r-gal/CNC/PCB/axePort_sch.kicad_sch

## KiCad design PCB/axePort_sch.kicad_sch (2025-07-07)

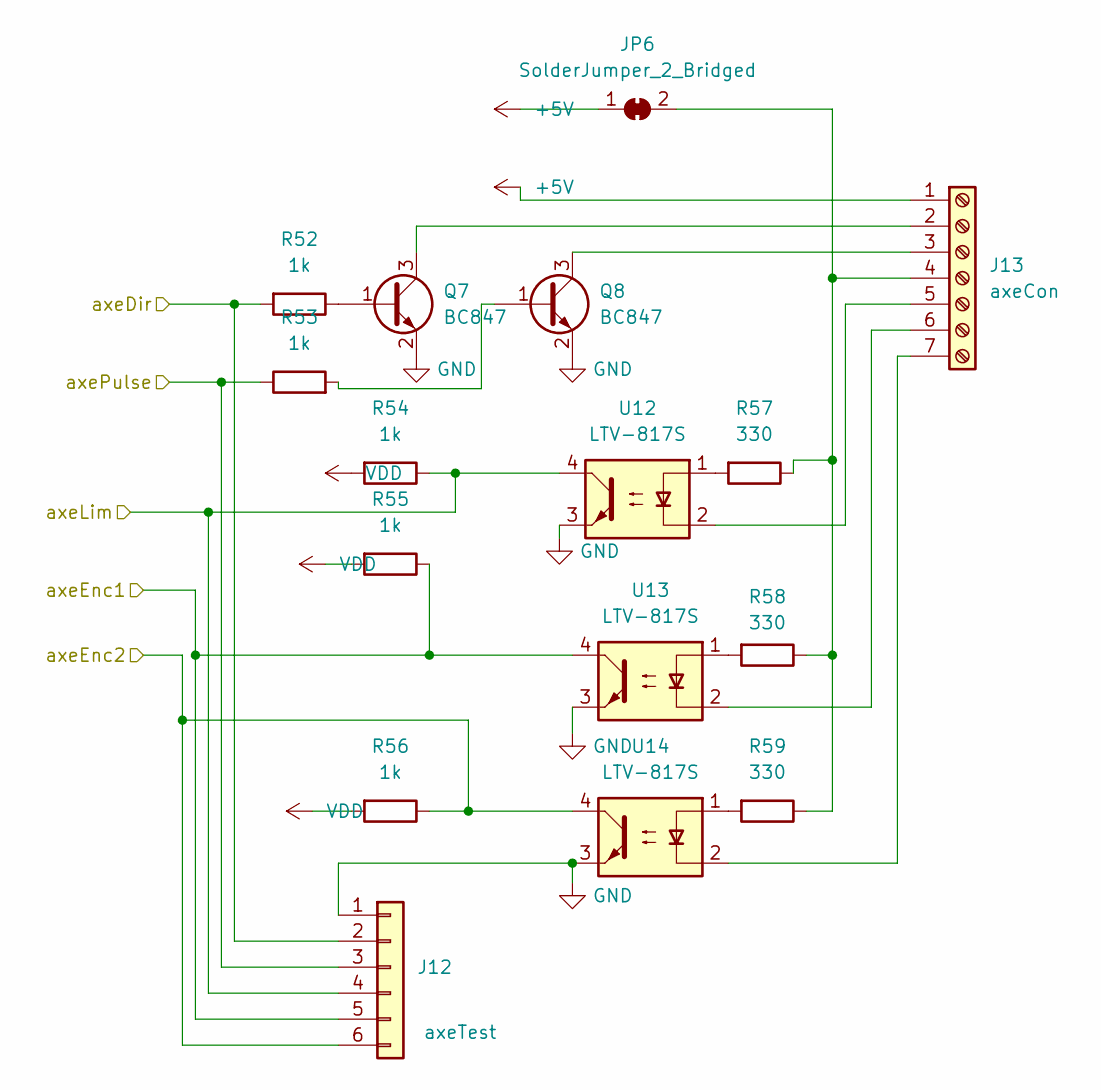
[picture p1: schematic axePort_sch.kicad_sch]

Parts:
J12: axeTest; PinHeader_1x06_P2.54mm_Vertical
J13: axeCon; TerminalBlock_4Ucon_1x07_P3.50mm_Horizontal
JP6: SolderJumper_2_Bridged; SolderJumper-2_P1.3mm_Open_RoundedPad1.0x1.5mm
Q7, Q8: BC847; SOT-23
R52, R53, R54, R55, R56: 1k; R_0805_2012Metric_Pad1.20x1.40mm_HandSolder
R57, R58, R59: 330; R_0805_2012Metric_Pad1.20x1.40mm_HandSolder
U12, U13, U14: LTV-817S; SMDIP-4_W9.53mm

Connections:
+5V: J13.1, JP6.1 (A)
GND: J12.1, Q7.2 (E), Q8.2 (E), U12.3, U13.3, U14.3
unnamed: J13.2, Q7.3 (C)
unnamed: J13.3, Q8.3 (C)
unnamed: J13.4, JP6.2 (B), R57.1, R58.1, R59.1
unnamed: J13.5, U12.2
unnamed: J13.6, U13.2
unnamed: J13.7, U14.2
unnamed: Q7.1 (B), R52.1
unnamed: Q8.1 (B), R53.2
unnamed: R57.2, U12.1
unnamed: R58.2, U13.1
unnamed: R59.2, U14.1
VDD: R54.2, R55.2, R56.2
axeDir: J12.2, R52.2
axeEnc1: J12.5, R55.1, U13.4
axeEnc2: J12.6, R56.1, U14.4
axeLim: J12.4, R54.1, U12.4
axePulse: J12.3, R53.1
