r-gal/CNC/PCB/ethernet.kicad_sch

## KiCad design PCB/ethernet.kicad_sch (2025-07-07)

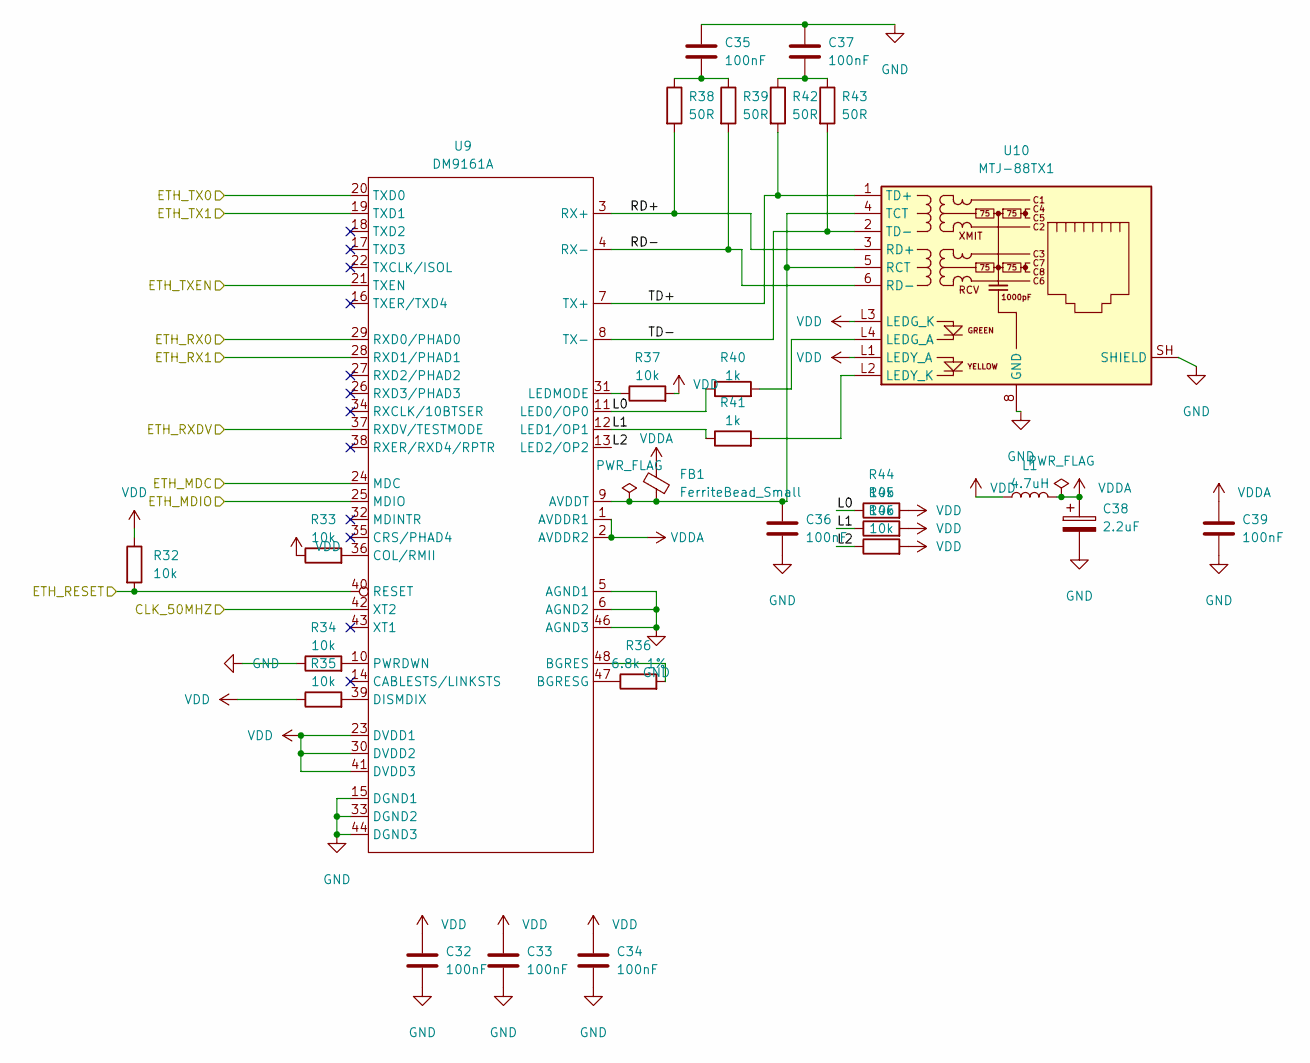
[picture p2: schematic ethernet.kicad_sch]

Parts:
C32, C33, C34, C35, C36, C37, C39: 100nF; C_0603_1608Metric_Pad1.08x0.95mm_HandSolder
C38: 2.2uF; CP_EIA-3216-18_Kemet-A
FB1: FerriteBead_Small; L_1206_3216Metric_Pad1.22x1.90mm_HandSolder
L1: 4.7uH; L_1806_4516Metric_Pad1.45x1.90mm_HandSolder
R32, R33, R34, R35, R37, R44, R45, R46: 10k; R_0805_2012Metric_Pad1.20x1.40mm_HandSolder
R36: 6.8k 1%; R_0805_2012Metric_Pad1.20x1.40mm_HandSolder
R38, R39, R42, R43: 50R; R_0805_2012Metric_Pad1.20x1.40mm_HandSolder
R40, R41: 1k; R_0805_2012Metric_Pad1.20x1.40mm_HandSolder
U9: DM9161A; LQFP-48_7x7mm_P0.5mm
U10: MTJ-88TX1; MTJ-88TX1-FSP

Connections:
CLK_50MHZ: U9.42 (XT2)
ETH_MDC: U9.24 (MDC)
ETH_MDIO: U9.25 (MDIO)
ETH_RESET: R32.2, U9.40 (RESET)
ETH_RX0: U9.29 (RXD0/PHAD0)
ETH_RX1: U9.28 (RXD1/PHAD1)
ETH_RXDV: U9.37 (RXDV/TESTMODE)
ETH_TX0: U9.20 (TXD0)
ETH_TX1: U9.19 (TXD1)
ETH_TXEN: U9.21 (TXEN)
GND: C32.2, C33.2, C34.2, C35.1, C36.2, C37.1, C38.2, C39.2, R34.1, U9.5 (AGND1), U9.6 (AGND2), U9.15 (DGND1), U9.33 (DGND2), U9.44 (DGND3), U9.46 (AGND3), U10.8 (GND), U10.SH (SHIELD)
L0: R40.1, R44.1, U9.11 (LED0/OP0)
L1: R41.1, R45.1, U9.12 (LED1/OP1)
L2: R46.1, U9.13 (LED2/OP2)
unnamed: C35.2, R38.1, R39.1
unnamed: C36.1, FB1.2, U9.9 (AVDDT), U10.4 (TCT), U10.5 (RCT)
unnamed: C37.2, R42.1, R43.1
unnamed: R33.2, U9.36 (COL/RMII)
unnamed: R34.2, U9.10 (PWRDWN)
unnamed: R35.2, U9.39 (DISMDIX)
unnamed: R36.1, U9.47 (BGRESG)
unnamed: R36.2, U9.48 (BGRES)
unnamed: R37.1, U9.31 (LEDMODE)
unnamed: R40.2, U10.L4 (LEDG_A)
unnamed: R41.2, U10.L2 (LEDY_K)
RD+: R38.2, U9.3 (RX+), U10.3 (RD+)
RD-: R39.2, U9.4 (RX-), U10.6 (RD-)
TD+: R42.2, U9.7 (TX+), U10.1 (TD+)
TD-: R43.2, U9.8 (TX-), U10.2 (TD-)
VDD: C32.1, C33.1, C34.1, L1.1, R32.1, R33.1, R35.1, R37.2, R44.2, R45.2, R46.2, U9.23 (DVDD1), U9.30 (DVDD2), U9.41 (DVDD3), U10.L1 (LEDY_A), U10.L3 (LEDG_K)
VDDA: C38.1, C39.1, FB1.1, L1.2, U9.1 (AVDDR1), U9.2 (AVDDR2)
