r-gal/CNC/PCB/inputPort_sch.kicad_sch

## KiCad design PCB/inputPort_sch.kicad_sch (2025-07-07)

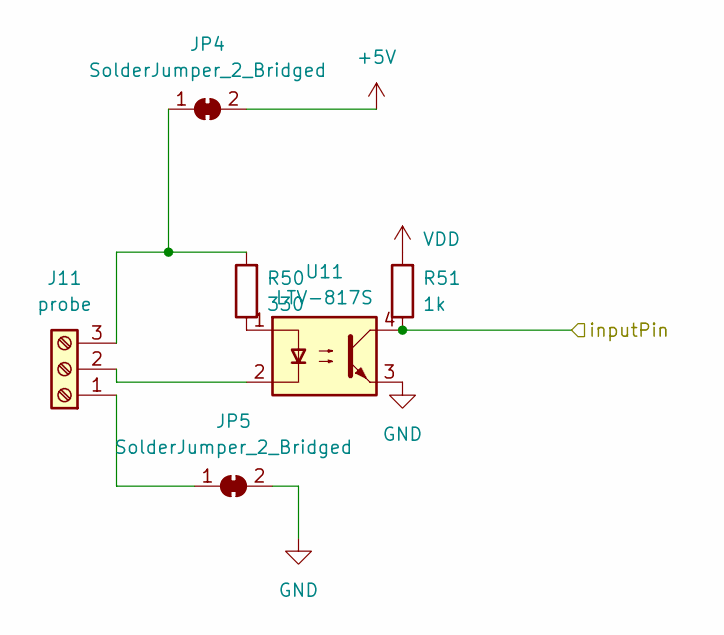
[picture p3: schematic inputPort_sch.kicad_sch]

Parts:
J11: probe; TerminalBlock_4Ucon_1x03_P3.50mm_Horizontal
JP4, JP5: SolderJumper_2_Bridged; SolderJumper-2_P1.3mm_Open_RoundedPad1.0x1.5mm
R50: 330; R_0805_2012Metric_Pad1.20x1.40mm_HandSolder
R51: 1k; R_0805_2012Metric_Pad1.20x1.40mm_HandSolder
U11: LTV-817S; SMDIP-4_W9.53mm

Connections:
+5V: JP4.2 (B)
GND: JP5.2 (B), U11.3
unnamed: J11.1, JP5.1 (A)
unnamed: J11.2, U11.2
unnamed: J11.3, JP4.1 (A), R50.2
unnamed: R50.1, U11.1
VDD: R51.2
inputPin: R51.1, U11.4
