r-gal/CNC/PCB/myCnc2.kicad_sch

## KiCad design PCB/myCnc2.kicad_sch (2025-07-07)

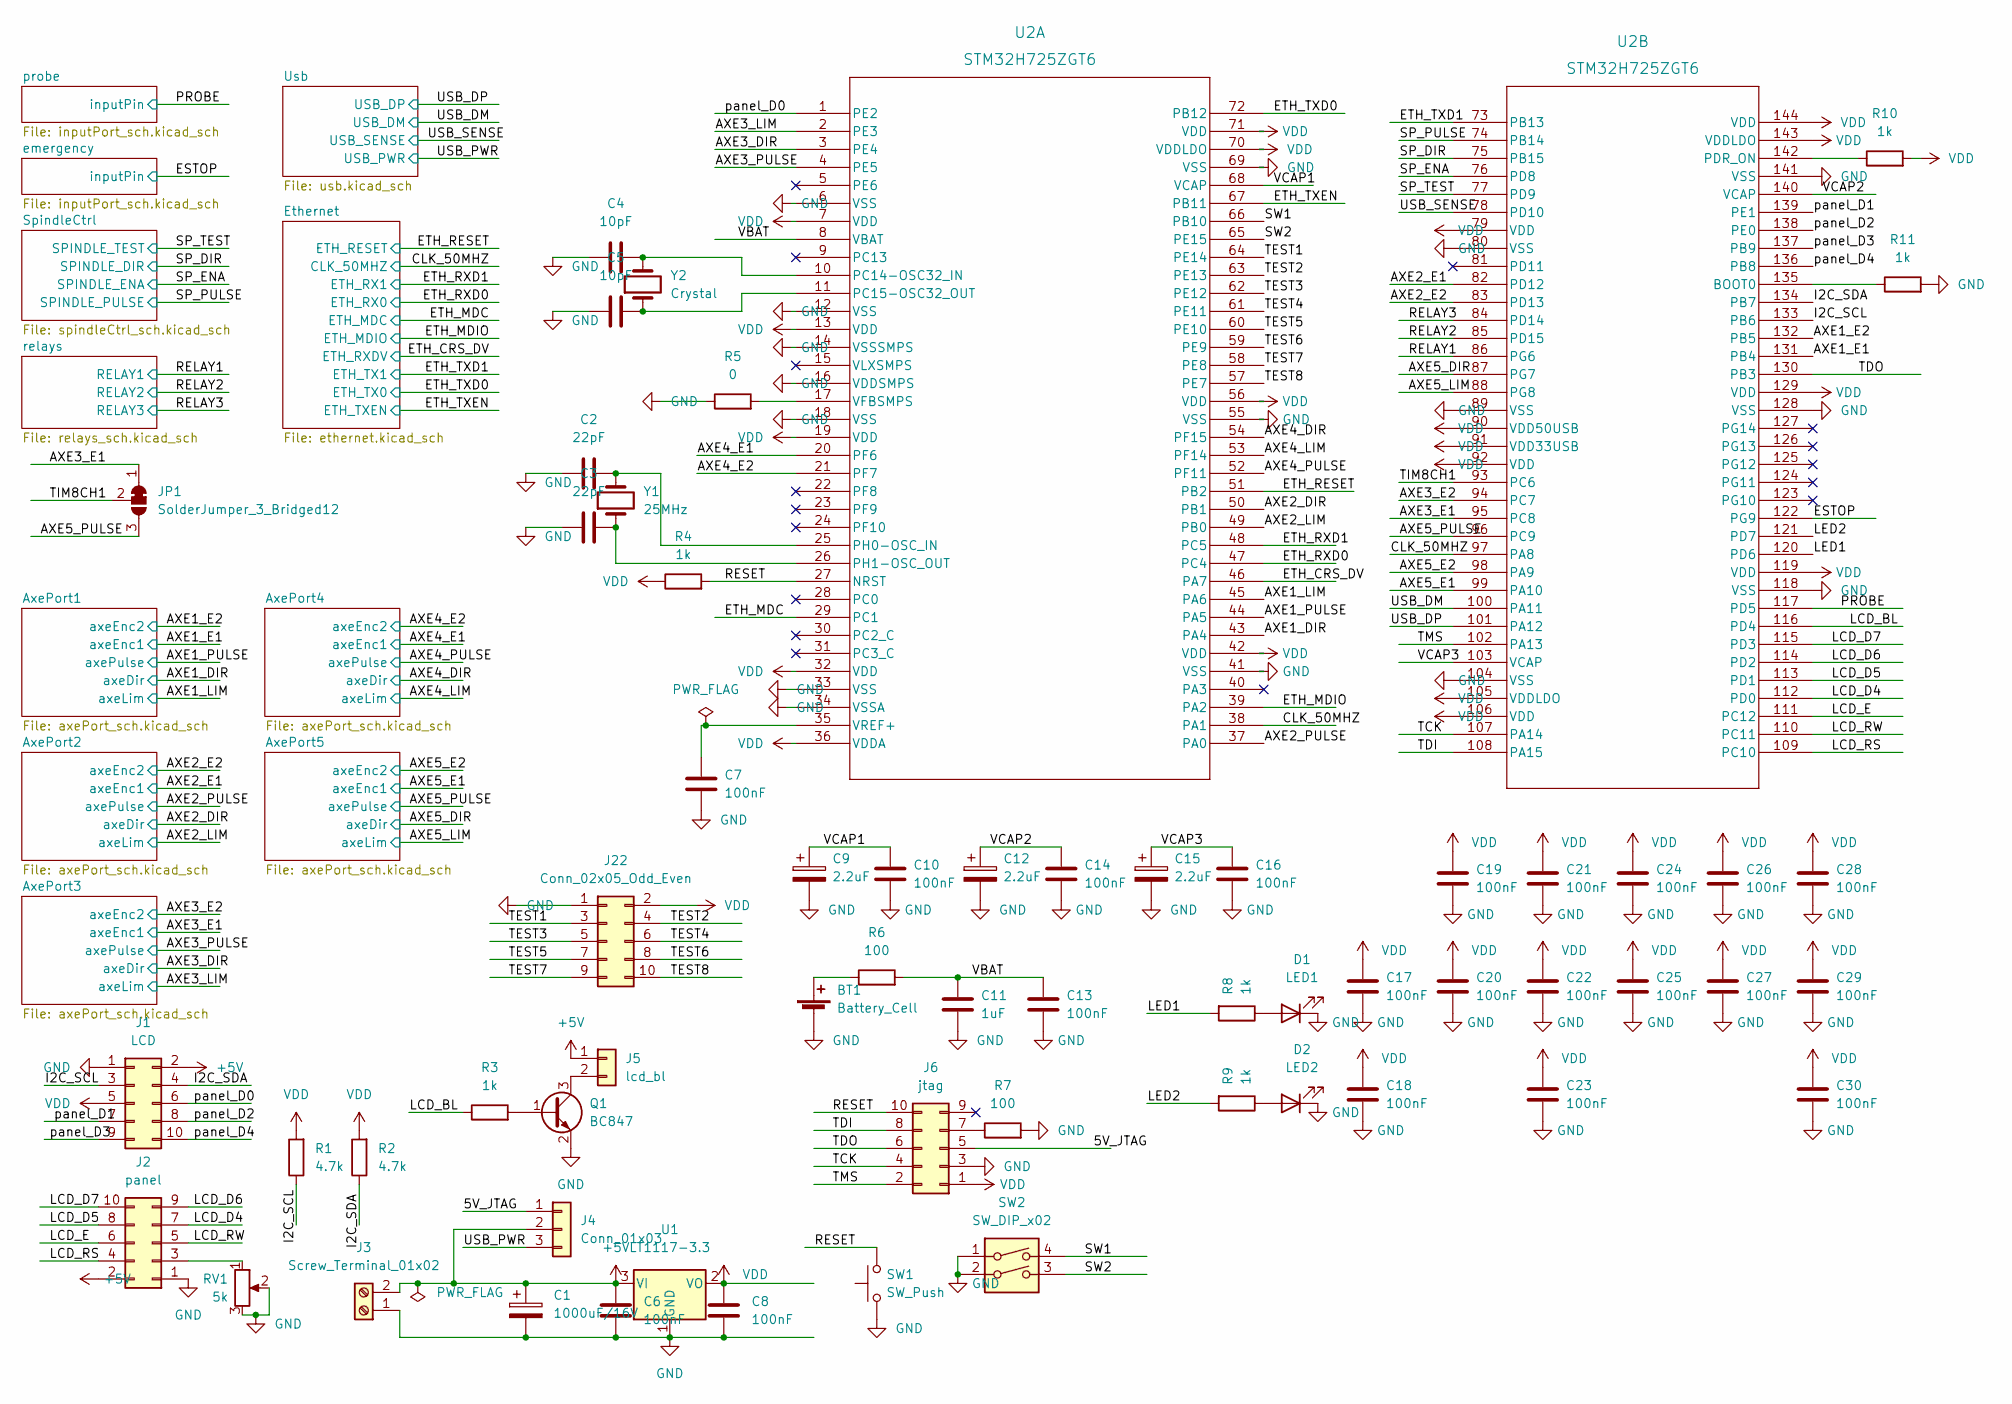
[picture p4: schematic myCnc2.kicad_sch]

Parts:
BT1: Battery_Cell; DS-1092_CR2032_VERTICAL
C1: 1000uF/16V; CP_Elec_10x12.5
C2, C3: 22pF; C_0603_1608Metric_Pad1.08x0.95mm_HandSolder
C4, C5: 10pF; C_0603_1608Metric_Pad1.08x0.95mm_HandSolder
C6, C7, C8, C10, C13, C14, C16, C17, C18, C19, C20, C21, C22, C23, C24, C25, C26, C27, C28, C29, C30: 100nF; C_0603_1608Metric_Pad1.08x0.95mm_HandSolder
C9, C12, C15: 2.2uF; CP_EIA-3216-18_Kemet-A
C11: 1uF; C_1206_3216Metric
D1: LED1; LED_1206_3216Metric_Pad1.42x1.75mm_HandSolder
D2: LED2; LED_1206_3216Metric_Pad1.42x1.75mm_HandSolder
J1: LCD; IDC-Header_2x05_P2.54mm_Vertical
J2: panel; IDC-Header_2x05_P2.54mm_Vertical
J3: Screw_Terminal_01x02; TerminalBlock_Phoenix_MKDS-1,5-2_1x02_P5.00mm_Horizontal
J4: Conn_01x03; PinHeader_1x03_P2.54mm_Vertical
J5: lcd_bl; PinHeader_1x02_P2.54mm_Vertical
J6: jtag; IDC-Header_2x05_P2.54mm_Vertical
J22: Conn_02x05_Odd_Even; PinHeader_2x05_P2.54mm_Vertical
JP1: SolderJumper_3_Bridged12; SolderJumper-3_P1.3mm_Open_RoundedPad1.0x1.5mm
Q1: BC847; SOT-23
R1, R2: 4.7k; R_0805_2012Metric_Pad1.20x1.40mm_HandSolder
R3, R4, R8, R9, R10, R11: 1k; R_0805_2012Metric_Pad1.20x1.40mm_HandSolder
R5: 0; R_0805_2012Metric_Pad1.20x1.40mm_HandSolder
R6, R7: 100; R_0805_2012Metric_Pad1.20x1.40mm_HandSolder
RV1: 5k; Potentiometer_Piher_PT-6-V_Vertical
SW1: SW_Push; SW_PUSH_6mm
SW2: SW_DIP_x02; SW_DIP_SPSTx02_Slide_9.78x7.26mm_W7.62mm_P2.54mm
U1: LT1117-3.3; SOT-223-3_TabPin2
U2: STM32H725ZGT6; LQFP_25ZGT6_STM
Y1: 25MHz; Crystal_SMD_HC49-SD
Y2: Crystal; Crystal_AT310_D3.0mm_L10.0mm_Vertical

Connections:
5V_JTAG: J4.1, J6.5
+5V: C1.1, C6.1, J1.2, J2.2, J3.2, J4.2, J5.1, U1.3 (VI)
AXE1_DIR: U2.43 (PA4)
AXE1_E1: U2.131 (PB4)
AXE1_E2: U2.132 (PB5)
AXE1_LIM: U2.45 (PA6)
AXE1_PULSE: U2.44 (PA5)
AXE2_DIR: U2.50 (PB1)
AXE2_E1: U2.82 (PD12)
AXE2_E2: U2.83 (PD13)
AXE2_LIM: U2.49 (PB0)
AXE2_PULSE: U2.37 (PA0)
AXE3_DIR: U2.3 (PE4)
AXE3_E1: JP1.1 (A), U2.95 (PC8)
AXE3_E2: U2.94 (PC7)
AXE3_LIM: U2.2 (PE3)
AXE3_PULSE: U2.4 (PE5)
AXE4_DIR: U2.54 (PF15)
AXE4_E1: U2.20 (PF6)
AXE4_E2: U2.21 (PF7)
AXE4_LIM: U2.53 (PF14)
AXE4_PULSE: U2.52 (PF11)
AXE5_DIR: U2.87 (PG7)
AXE5_E1: U2.99 (PA10)
AXE5_E2: U2.98 (PA9)
AXE5_LIM: U2.88 (PG8)
AXE5_PULSE: JP1.3 (B), U2.96 (PC9)
CLK_50MHZ: U2.38 (PA1), U2.97 (PA8)
ESTOP: U2.122 (PG9)
ETH_CRS_DV: U2.46 (PA7)
ETH_MDC: U2.29 (PC1)
ETH_MDIO: U2.39 (PA2)
ETH_RESET: U2.51 (PB2)
ETH_RXD0: U2.47 (PC4)
ETH_RXD1: U2.48 (PC5)
ETH_TXD0: U2.72 (PB12)
ETH_TXD1: U2.73 (PB13)
ETH_TXEN: U2.67 (PB11)
GND: BT1.2 (-), C1.2, C2.1, C3.1, C4.1, C5.1, C6.2, C7.2, C8.2, C9.2, C10.2, C11.2, C12.2, C13.2, C14.2, C15.2, C16.2, C17.2, C18.2, C19.2, C20.2, C21.2, C22.2, C23.2, C24.2, C25.2, C26.2, C27.2, C28.2, C29.2, C30.2, D1.1 (K), D2.1 (K), J1.1, J2.1, J3.1, J6.3, J22.1, Q1.2 (E), R5.1, R7.2, R11.2, RV1.2, RV1.3, SW1.1, SW2.1, SW2.2, U1.1 (GND), U2.6 (VSS), U2.12 (VSS), U2.14 (VSSSMPS), U2.16 (VDDSMPS), U2.18 (VSS), U2.33 (VSS), U2.34 (VSSA), U2.41 (VSS), U2.55 (VSS), U2.69 (VSS), U2.80 (VSS), U2.89 (VSS), U2.104 (VSS), U2.118 (VSS), U2.128 (VSS), U2.141 (VSS)
I2C_SCL: J1.3, R1.1, U2.133 (PB6)
I2C_SDA: J1.4, R2.1, U2.134 (PB7)
LCD_BL: R3.1, U2.116 (PD4)
LCD_D4: J2.7, U2.112 (PD0)
LCD_D5: J2.8, U2.113 (PD1)
LCD_D6: J2.9, U2.114 (PD2)
LCD_D7: J2.10, U2.115 (PD3)
LCD_E: J2.6, U2.111 (PC12)
LCD_RS: J2.4, U2.109 (PC10)
LCD_RW: J2.5, U2.110 (PC11)
LED1: R8.2, U2.120 (PD6)
LED2: R9.2, U2.121 (PD7)
unnamed: BT1.1 (+), R6.1
unnamed: C2.2, U2.25 (PH0-OSC_IN), Y1.2
unnamed: C3.2, U2.26 (PH1-OSC_OUT), Y1.1
unnamed: C4.2, U2.10 (PC14-OSC32_IN), Y2.2
unnamed: C5.2, U2.11 (PC15-OSC32_OUT), Y2.1
unnamed: C7.1, U2.35 (VREF+)
unnamed: D1.2 (A), R8.1
unnamed: D2.2 (A), R9.1
unnamed: J2.3, RV1.1
unnamed: J5.2, Q1.3 (C)
unnamed: J6.7, R7.1
unnamed: Q1.1 (B), R3.2
unnamed: R5.2, U2.17 (VFBSMPS)
unnamed: R10.1, U2.142 (PDR_ON)
unnamed: R11.1, U2.135 (BOOT0)
PROBE: U2.117 (PD5)
RELAY1: U2.86 (PG6)
RELAY2: U2.85 (PD15)
RELAY3: U2.84 (PD14)
RESET: J6.10, R4.2, SW1.2, U2.27 (NRST)
SP_DIR: U2.75 (PB15)
SP_ENA: U2.76 (PD8)
SP_PULSE: U2.74 (PB14)
SP_TEST: U2.77 (PD9)
SW1: SW2.4, U2.66 (PB10)
SW2: SW2.3, U2.65 (PE15)
TCK: J6.4, U2.107 (PA14)
TDI: J6.8, U2.108 (PA15)
TDO: J6.6, U2.130 (PB3)
TEST1: J22.3, U2.64 (PE14)
TEST2: J22.4, U2.63 (PE13)
TEST3: J22.5, U2.62 (PE12)
TEST4: J22.6, U2.61 (PE11)
TEST5: J22.7, U2.60 (PE10)
TEST6: J22.8, U2.59 (PE9)
TEST7: J22.9, U2.58 (PE8)
TEST8: J22.10, U2.57 (PE7)
TIM8CH1: JP1.2 (C), U2.93 (PC6)
TMS: J6.2, U2.102 (PA13)
USB_DM: U2.100 (PA11)
USB_DP: U2.101 (PA12)
USB_PWR: J4.3
USB_SENSE: U2.78 (PD10)
VBAT: C11.1, C13.1, R6.2, U2.8 (VBAT)
VCAP1: C9.1, C10.1, U2.68 (VCAP)
VCAP2: C12.1, C14.1, U2.140 (VCAP)
VCAP3: C15.1, C16.1, U2.103 (VCAP)
VDD: C8.1, C17.1, C18.1, C19.1, C20.1, C21.1, C22.1, C23.1, C24.1, C25.1, C26.1, C27.1, C28.1, C29.1, C30.1, J1.5, J6.1, J22.2, R1.2, R2.2, R4.1, R10.2, U1.2 (VO), U2.7 (VDD), U2.13 (VDD), U2.19 (VDD), U2.32 (VDD), U2.36 (VDDA), U2.42 (VDD), U2.56 (VDD), U2.70 (VDDLDO), U2.71 (VDD), U2.79 (VDD), U2.90 (VDD50USB), U2.91 (VDD33USB), U2.92 (VDD), U2.105 (VDDLDO), U2.106 (VDD), U2.119 (VDD), U2.129 (VDD), U2.143 (VDDLDO), U2.144 (VDD)
panel_D0: J1.6, U2.1 (PE2)
panel_D1: J1.7, U2.139 (PE1)
panel_D2: J1.8, U2.138 (PE0)
panel_D3: J1.9, U2.137 (PB9)
panel_D4: J1.10, U2.136 (PB8)
