r-gal/CNC/PCB/relays_sch.kicad_sch

## KiCad design PCB/relays_sch.kicad_sch (2025-07-07)

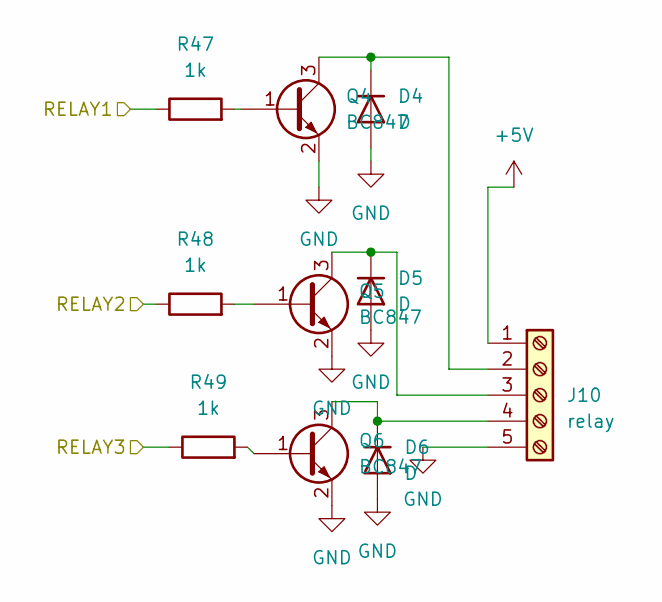
[picture p5: schematic relays_sch.kicad_sch]

Parts:
D4, D5, D6: D; D_MiniMELF
J10: relay; TerminalBlock_4Ucon_1x05_P3.50mm_Horizontal
Q4, Q5, Q6: BC847; SOT-23
R47, R48, R49: 1k; R_0805_2012Metric_Pad1.20x1.40mm_HandSolder

Connections:
+5V: J10.1
GND: D4.2 (A), D5.2 (A), D6.2 (A), J10.5, Q4.2 (E), Q5.2 (E), Q6.2 (E)
unnamed: D4.1 (K), J10.2, Q4.3 (C)
unnamed: D5.1 (K), J10.3, Q5.3 (C)
unnamed: D6.1 (K), J10.4, Q6.3 (C)
unnamed: Q4.1 (B), R47.2
unnamed: Q5.1 (B), R48.2
unnamed: Q6.1 (B), R49.2
RELAY1: R47.1
RELAY2: R48.1
RELAY3: R49.1
