r-gal/CNC/PCB/spindleCtrl_sch.kicad_sch

## KiCad design PCB/spindleCtrl_sch.kicad_sch (2025-07-07)

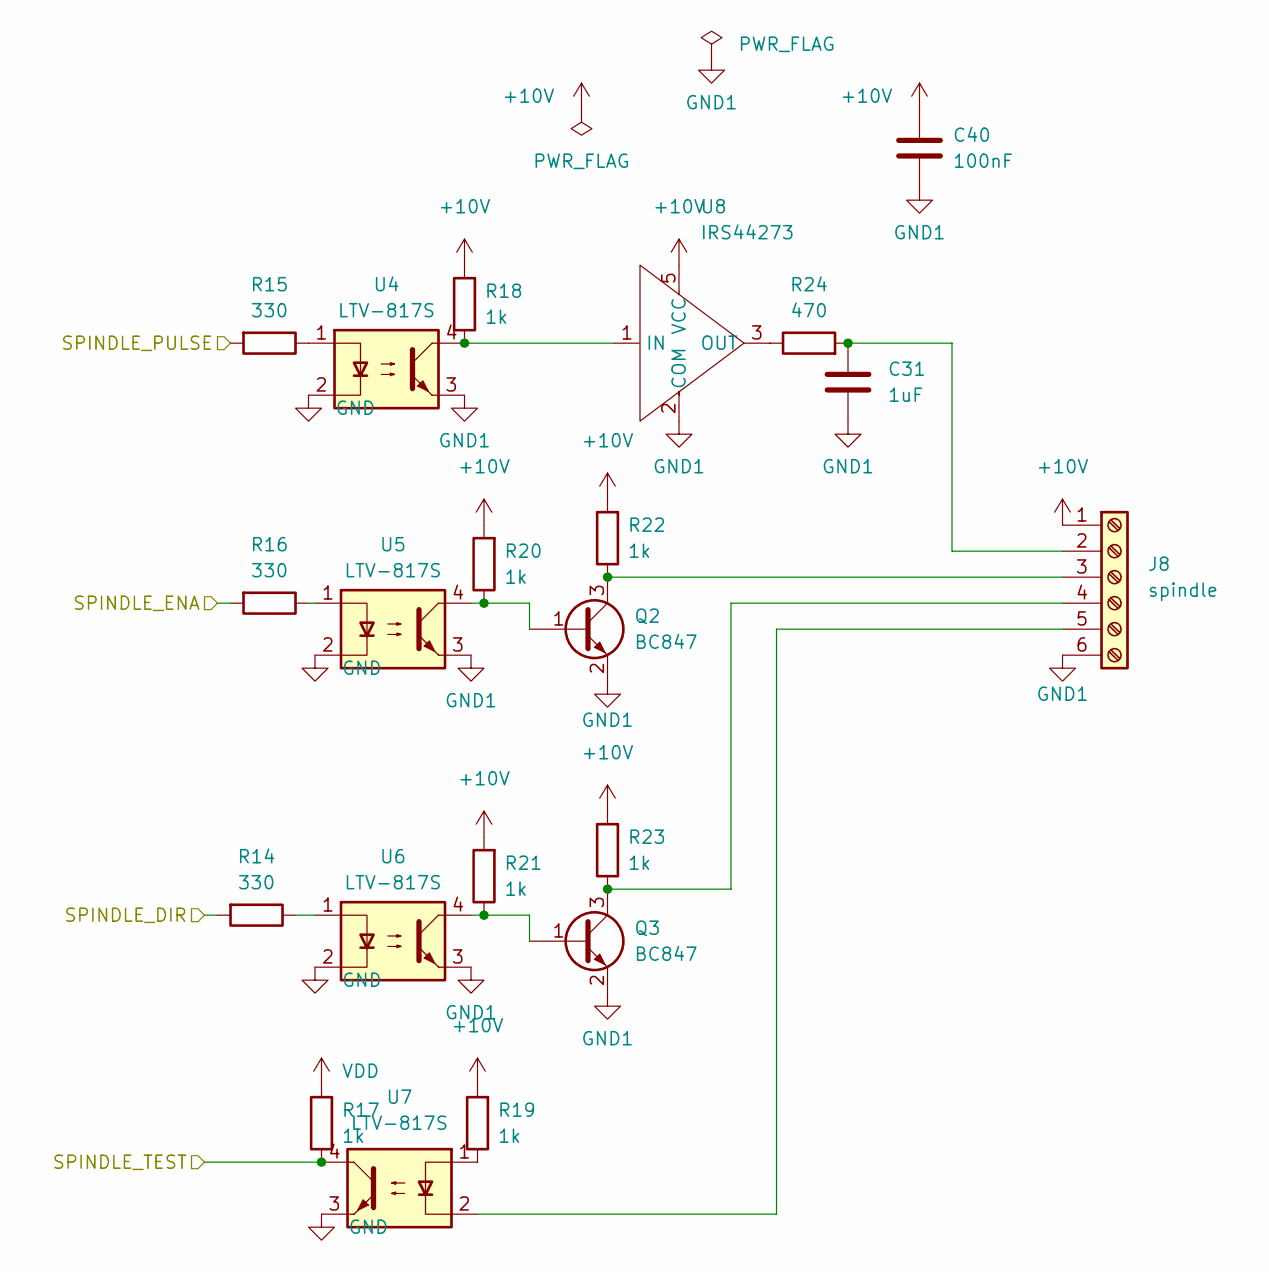
[picture p6: schematic spindleCtrl_sch.kicad_sch]

Parts:
C31: 1uF; C_1206_3216Metric_Pad1.33x1.80mm_HandSolder
C40: 100nF; C_0603_1608Metric_Pad1.08x0.95mm_HandSolder
J8: spindle; TerminalBlock_4Ucon_1x06_P3.50mm_Horizontal
Q2, Q3: BC847; SOT-23
R14, R15, R16: 330; R_0805_2012Metric_Pad1.20x1.40mm_HandSolder
R17, R18, R19, R20, R21, R22, R23: 1k; R_0805_2012Metric_Pad1.20x1.40mm_HandSolder
R24: 470; R_0805_2012Metric_Pad1.20x1.40mm_HandSolder
U4, U5, U6, U7: LTV-817S; SMDIP-4_W9.53mm
U8: IRS44273; SOT-23-5_HandSoldering

Connections:
+10V: C40.1, J8.1, R18.2, R19.2, R20.2, R21.2, R22.2, R23.2, U8.5 (VCC)
GND: U4.2, U5.2, U6.2, U7.3
GND1: C31.2, C40.2, J8.6, Q2.2 (E), Q3.2 (E), U4.3, U5.3, U6.3, U8.2 (COM)
unnamed: C31.1, J8.2, R24.2
unnamed: J8.3, Q2.3 (C), R22.1
unnamed: J8.4, Q3.3 (C), R23.1
unnamed: J8.5, U7.2
unnamed: Q2.1 (B), R20.1, U5.4
unnamed: Q3.1 (B), R21.1, U6.4
unnamed: R14.1, U6.1
unnamed: R15.1, U4.1
unnamed: R16.1, U5.1
unnamed: R18.1, U4.4, U8.1 (IN)
unnamed: R19.1, U7.1
unnamed: R24.1, U8.3 (OUT), U8.4 (OUT)
SPINDLE_DIR: R14.2
SPINDLE_ENA: R16.2
SPINDLE_PULSE: R15.2
SPINDLE_TEST: R17.1, U7.4
VDD: R17.2
