r-gal/CNC/PCB/usb.kicad_sch

## KiCad design PCB/usb.kicad_sch (2025-07-07)

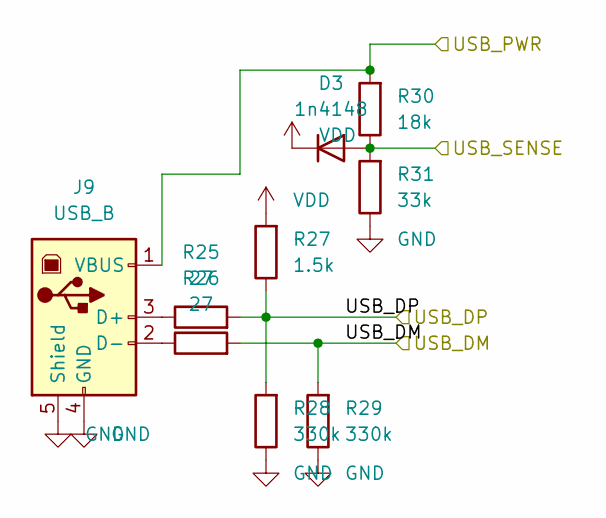
[picture p7: schematic usb.kicad_sch]

Parts:
D3: 1n4148; D_MiniMELF
J9: USB_B; USB_B_OST_USB-B1HSxx_Horizontal
R25, R26: 27; R_0805_2012Metric_Pad1.20x1.40mm_HandSolder
R27: 1.5k; R_0805_2012Metric_Pad1.20x1.40mm_HandSolder
R28, R29: 330k; R_0805_2012Metric_Pad1.20x1.40mm_HandSolder
R30: 18k; R_0805_2012Metric_Pad1.20x1.40mm_HandSolder
R31: 33k; R_0805_2012Metric_Pad1.20x1.40mm_HandSolder

Connections:
GND: J9.4 (GND), J9.5 (Shield), R28.1, R29.1, R31.1
unnamed: J9.2 (D-), R26.1
unnamed: J9.3 (D+), R25.1
USB_DM: R26.2, R29.2
USB_DP: R25.2, R27.1, R28.2
USB_PWR: J9.1 (VBUS), R30.2
USB_SENSE: D3.2 (A), R30.1, R31.2
VDD: D3.1 (K), R27.2
