r-gal/CNC/(commit log)

2025-07-07 add PCB
    [axePort_sch.kicad_sch, ethernet.kicad_sch, inputPort_sch.kicad_sch, myCnc2.csv, myCnc2.kicad_sch, ports.kicad_sch, power.kicad_sch, relays_sch.kicad_sch]
2025-07-10 fix spindle speed setting
2025-07-10 Add files via upload
    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
    [myCnc2_v2.ioc]
2025-08-01 fix surface offset crashes
    [myCnc2_v2.ioc]
2025-12-11 Interrupts race fault fix
